tjlab-jf3hzb/All_mode_SDR/photo01.jpg

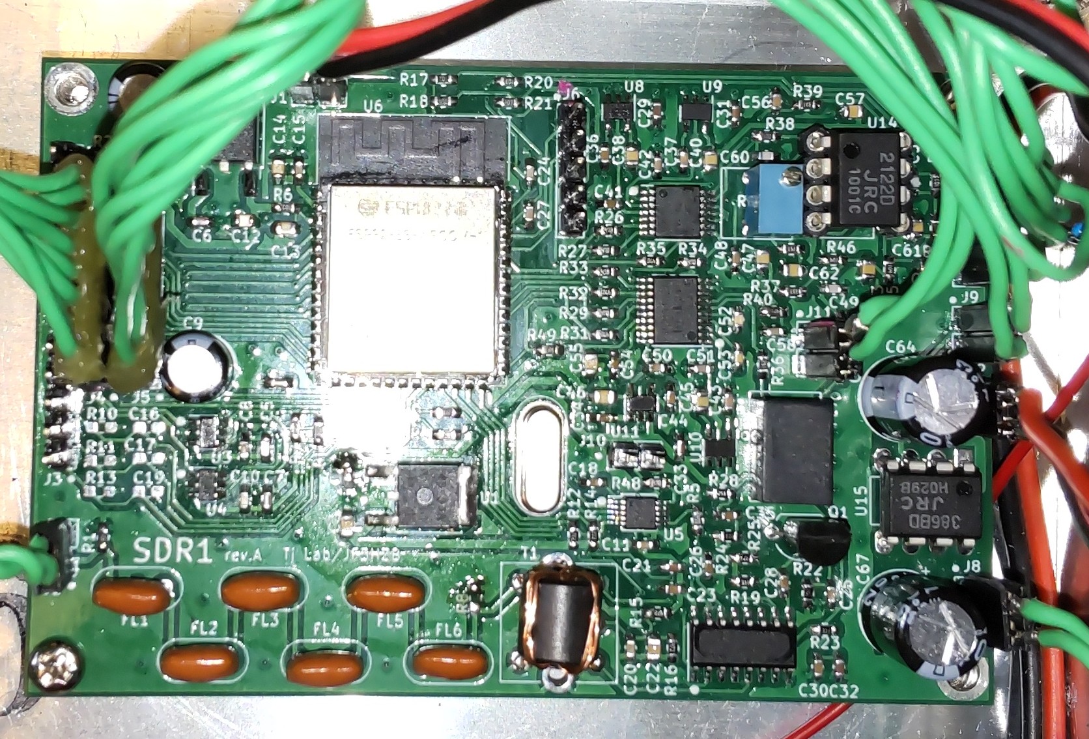
photo01.jpg
