tjlab-jf3hzb/All_mode_SDR/photo02.jpg

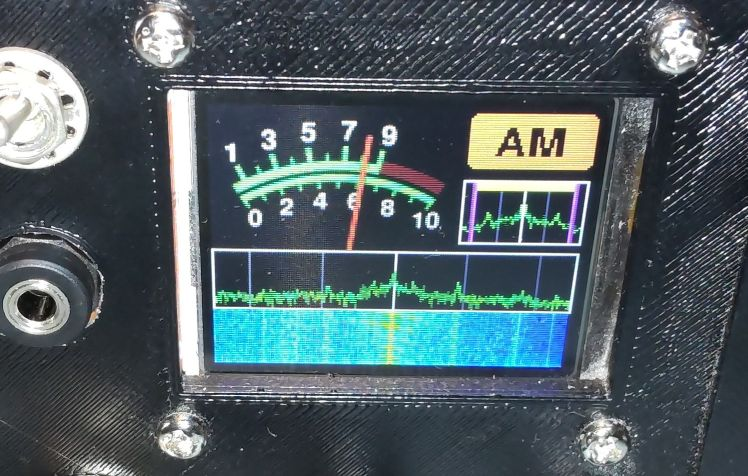
photo02.jpg
