tjlab-jf3hzb/All_mode_SDR/block_diagram.jpg

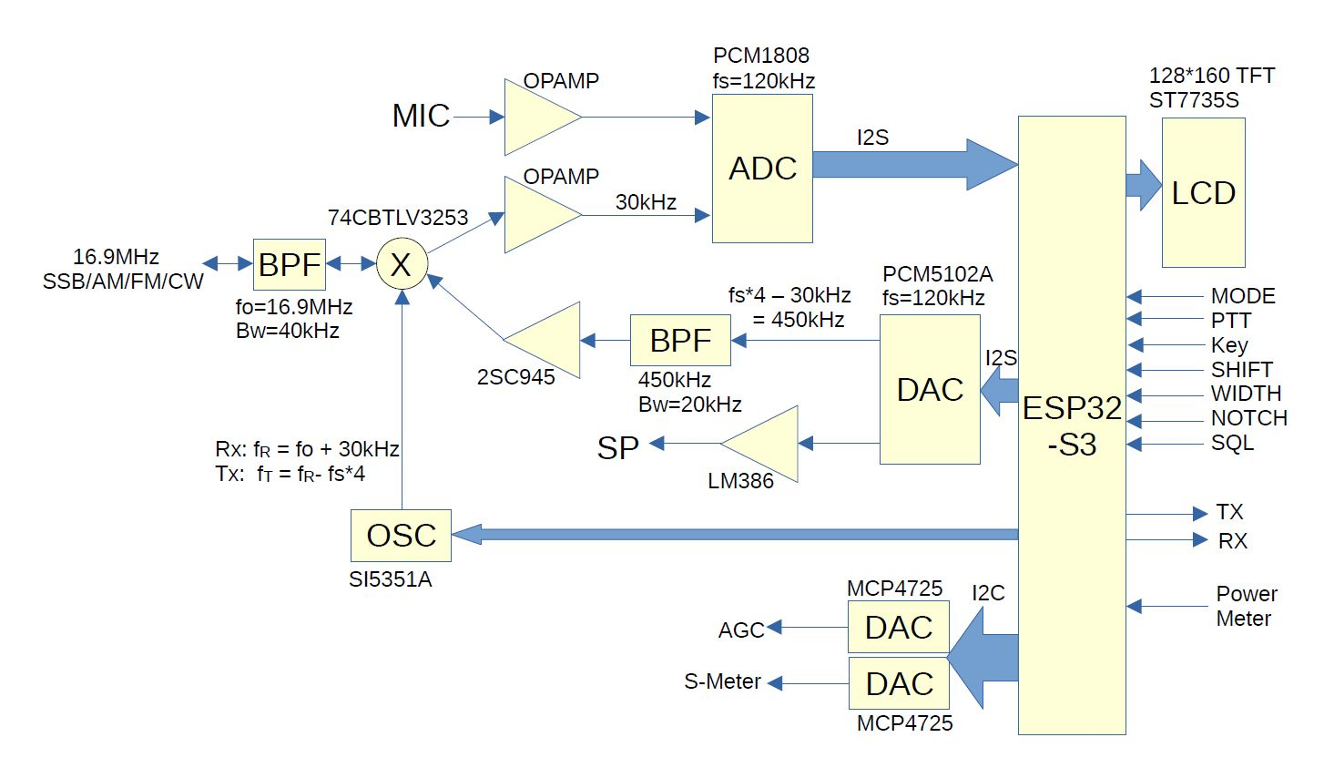
block_diagram.jpg
