tjlab-jf3hzb/All_mode_SDR/Compile_settings.jpg

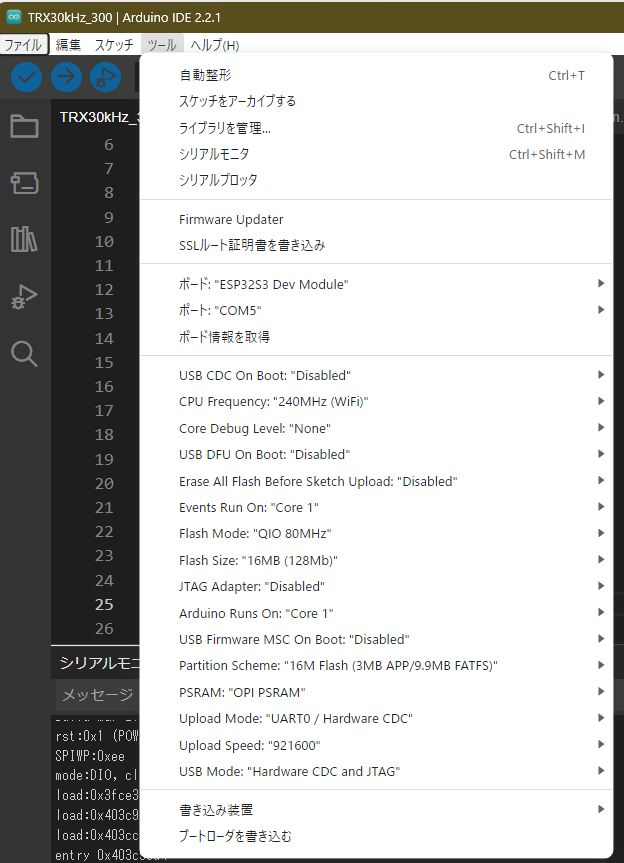
Compile_settings.jpg
