tjlab-jf3hzb/All_mode_SDR/connection_ver200.bmp

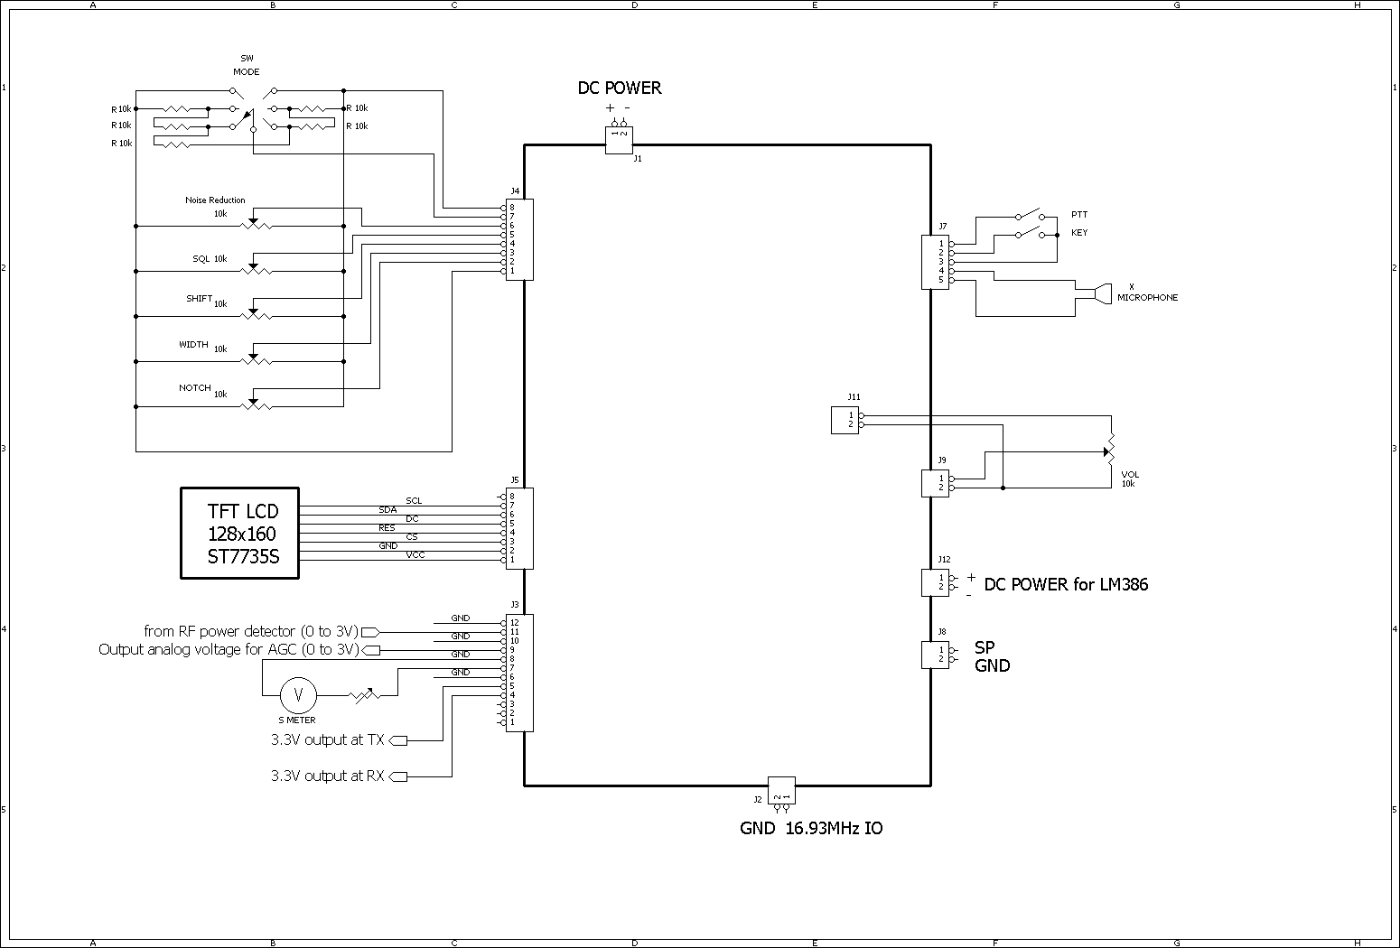
connection_ver200.bmp
