tjlab-jf3hzb/All_mode_SDR/schematic diagram.pdf

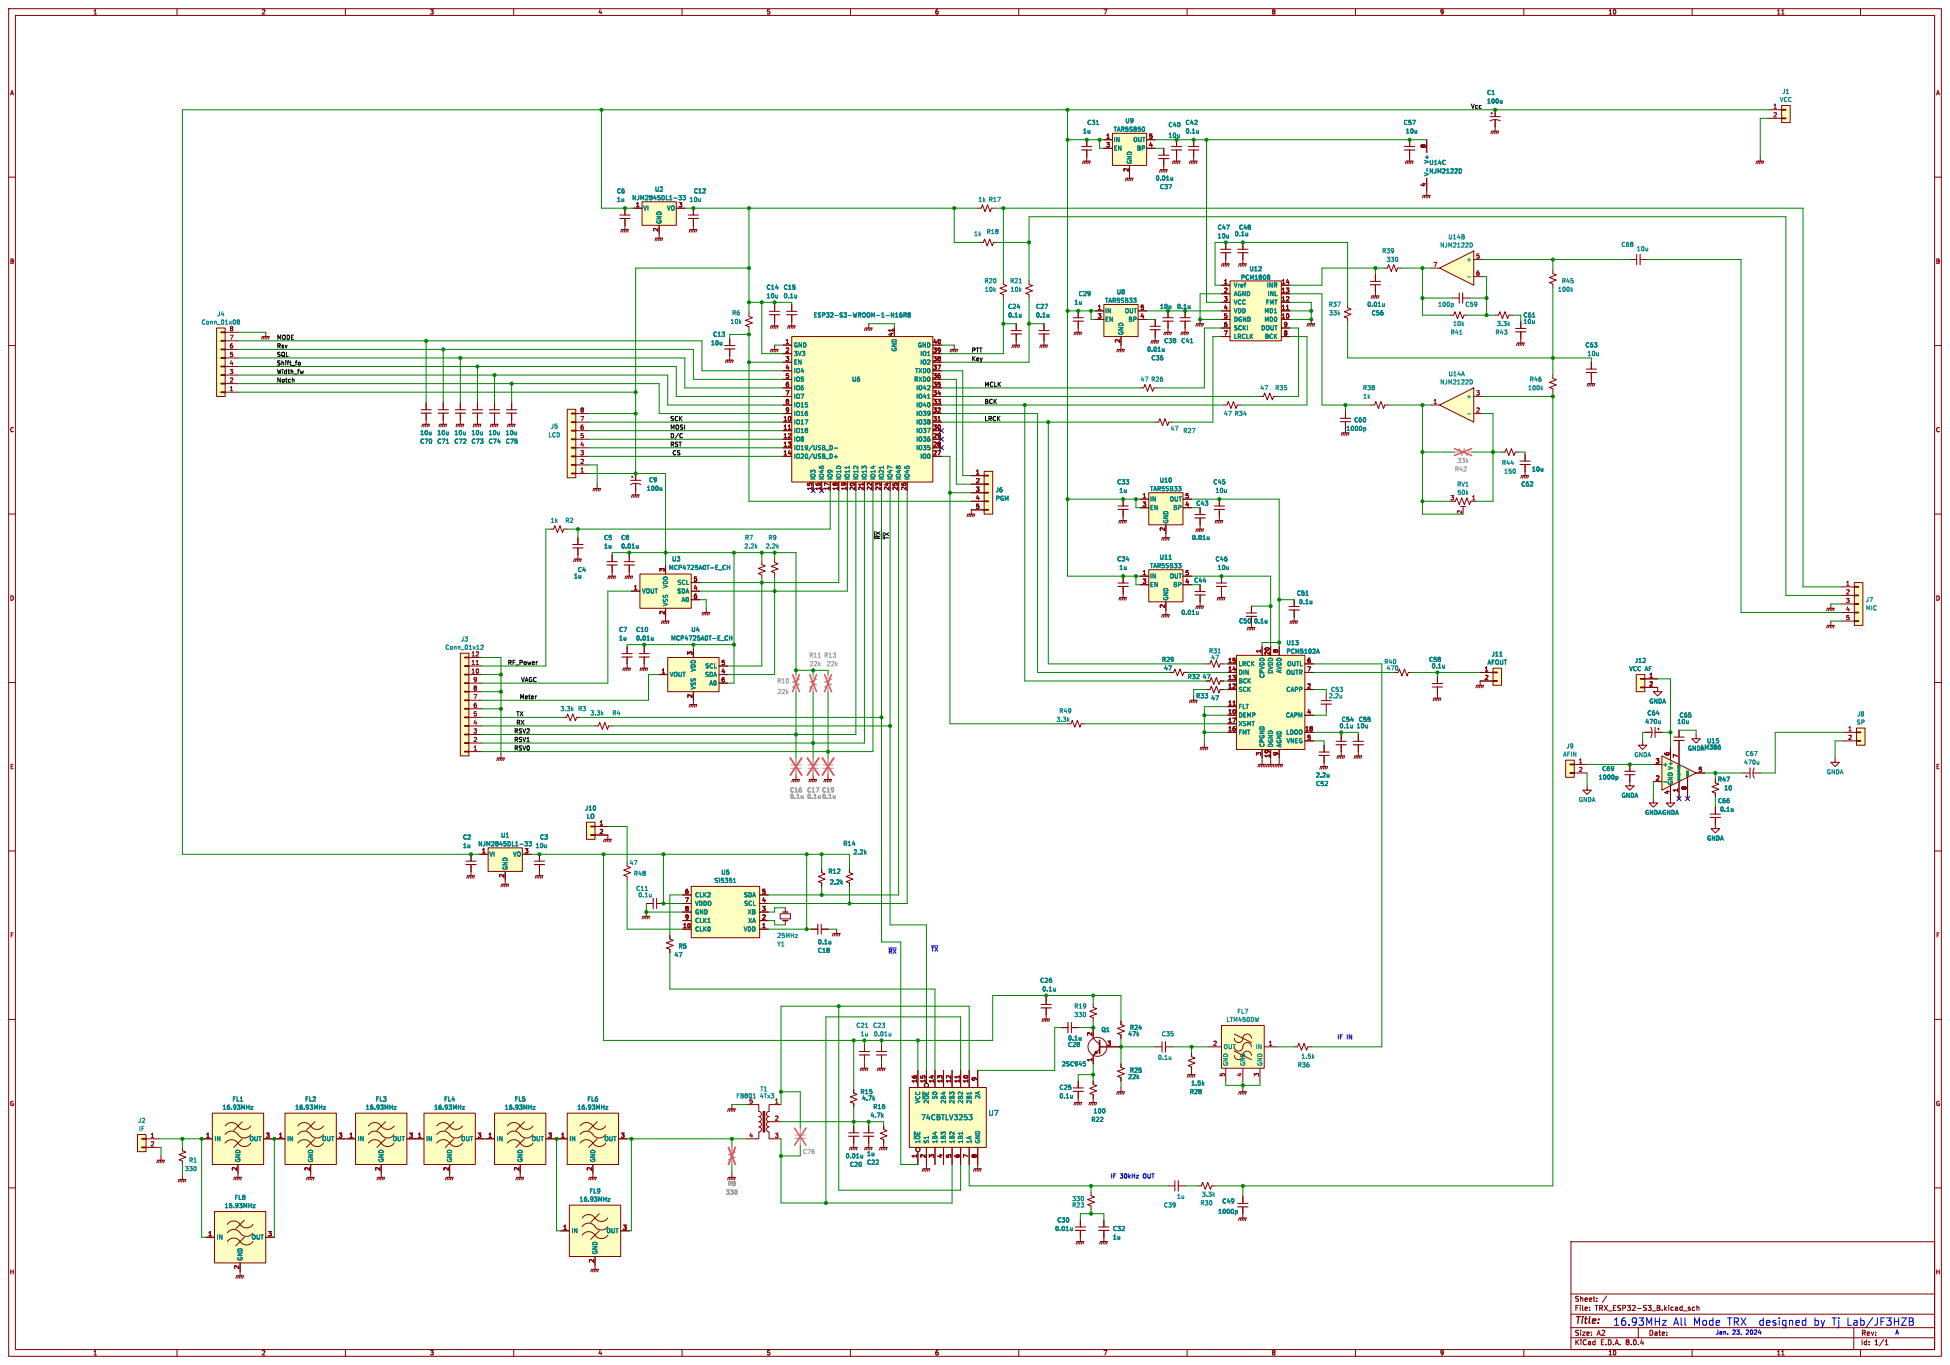
[picture p6: page 1]

2 OUT 3 U7 74CBTLV3253 1~{OE} 1 2B1 10 2B2 11 2B3 12 2B4 13 S0 14 2~{OE} 15 VCC 16 S1

A 16.93MHz All Mode TRX designed by Tj Lab/JF3HZB
