tjlab-jf3hzb/All_mode_SDR/trx16M_205/ejwt.h

#define Nb_max 12
#define Nmax  (1<<Nb_max)

// twiddle factor (real part)
const float wr[]={
1.000000000e+000,
9.999988235e-001,
9.999952938e-001,
9.999894111e-001,
9.999811753e-001,
9.999705864e-001,
9.999576446e-001,
9.999423497e-001,
9.999247018e-001,
9.999047011e-001,
9.998823475e-001,
9.998576410e-001,
9.998305818e-001,
9.998011699e-001,
9.997694054e-001,
9.997352883e-001,
9.996988187e-001,
9.996599967e-001,
9.996188225e-001,
9.995752960e-001,
9.995294175e-001,
9.994811870e-001,
9.994306046e-001,
9.993776704e-001,
9.993223846e-001,
9.992647473e-001,
9.992047586e-001,
9.991424187e-001,
9.990777278e-001,
9.990106859e-001,
9.989412932e-001,
9.988695499e-001,
9.987954562e-001,
9.987190122e-001,
9.986402182e-001,
9.985590742e-001,
9.984755806e-001,
9.983897374e-001,
9.983015449e-001,
9.982110034e-001,
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
};

// twiddle factor (imaginary part)
const float wi[]={
-0.000000000e+000,
-1.533980186e-003,
-3.067956763e-003,
-4.601926120e-003,
-6.135884649e-003,
-7.669828740e-003,
-9.203754782e-003,
-1.073765917e-002,
-1.227153829e-002,
-1.380538853e-002,
-1.533920628e-002,
-1.687298795e-002,
-1.840672991e-002,
-1.994042855e-002,
-2.147408028e-002,
-2.300768147e-002,
-2.454122852e-002,
-2.607471783e-002,
-2.760814578e-002,
-2.914150876e-002,
-3.067480318e-002,
-3.220802541e-002,
-3.374117185e-002,
-3.527423890e-002,
-3.680722294e-002,
-3.834012037e-002,
-3.987292759e-002,
-4.140564098e-002,
-4.293825693e-002,
-4.447077185e-002,
-4.600318213e-002,
-4.753548416e-002,
-4.906767433e-002,
-5.059974904e-002,
-5.213170468e-002,
-5.366353765e-002,
-5.519524435e-002,
-5.672682117e-002,
-5.825826450e-002,
-5.978957075e-002,
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
};
