tjlab-jf3hzb/All_mode_SDR/trx16M_205/ST7735S_128x160_2.hpp

#ifndef DISPLAY_H
#define	DISPLAY_H

#include <LovyanGFX.hpp>
class LGFX : public lgfx::LGFX_Device
{
  lgfx::Panel_ST7735S _panel_instance;
  lgfx::Bus_SPI       _bus_instance;

public:
  LGFX(void)
  {
    { // // SPIバスの設定
      auto cfg = _bus_instance.config();    // バス設定用の構造体を取得します。
      cfg.spi_host = SPI3_HOST;     // 使用するSPIを選択  ESP32-S2,C3 : SPI2_HOST or SPI3_HOST / ESP32 : VSPI_HOST or HSPI_HOST
      // ※ ESP-IDFバージョンアップに伴い、VSPI_HOST , HSPI_HOSTの記述は非推奨になるため、エラーが出る場合は代わりにSPI2_HOST , SPI3_HOSTを使用してください。
      cfg.spi_mode = 0;             // SPI通信モードを設定 (0 ~ 3)
      cfg.freq_write = 27000000;    // 送信時のSPIクロック (最大80MHz, 80MHzを整数で割った値に丸められます)
      cfg.freq_read  = 16000000;    // 受信時のSPIクロック
      cfg.spi_3wire  = false;        // 受信をMOSIピンで行う場合はtrueを設定
      cfg.use_lock   = true;        // トランザクションロックを使用する場合はtrueを設定
      cfg.dma_channel = SPI_DMA_CH_AUTO; // 使用するDMAチャンネルを設定 (0=DMA不使用 / 1=1ch / 2=ch / SPI_DMA_CH_AUTO=自動設定)
      // ※ ESP-IDFバージョンアップに伴い、DMAチャンネルはSPI_DMA_CH_AUTO(自動設定)が推奨になりました。1ch,2chの指定は非推奨になります。
      cfg.pin_sclk = 17;            // SPIのSCLKピン番号を設定
      cfg.pin_mosi = 18;            // SPIのMOSIピン番号を設定
      cfg.pin_miso = -1;            // SPIのMISOピン番号を設定 (-1 = disable)
      cfg.pin_dc   =  8;            // SPIのD/Cピン番号を設定  (-1 = disable)
      _bus_instance.config(cfg);    // 設定値をバスに反映します。
      _panel_instance.setBus(&_bus_instance);      // バスをパネルにセットします。
    }

    { // 表示パネル制御の設定を行います。
      auto cfg = _panel_instance.config();    // 表示パネル設定用の構造体を取得します。
      cfg.pin_cs           =   20;  // CSが接続されているピン番号   (-1 = disable)
      cfg.pin_rst          =   19;  // RSTが接続されているピン番号  (-1 = disable)
      cfg.pin_busy         =   -1;  // BUSYが接続されているピン番号 (-1 = disable)

      // ※ 以下の設定値はパネル毎に一般的な初期値が設定されていますので、不明な項目はコメントアウトして試してみてください。

      cfg.panel_width      =   128;  // 実際に表示可能な幅
      cfg.panel_height     =   160;  // 実際に表示可能な高さ
      cfg.offset_x         =     2;  // パネルのX方向オフセット量
      cfg.offset_y         =    -1;  // パネルのY方向オフセット量
      cfg.offset_rotation  =     3;  // 回転方向の値のオフセット 0~7 (4~7は上下反転)
      cfg.dummy_read_pixel =     8;  // ピクセル読出し前のダミーリードのビット数
      cfg.dummy_read_bits  =     1;  // ピクセル以外のデータ読出し前のダミーリードのビット数
      cfg.readable         = false;  // データ読出しが可能な場合 trueに設定
      cfg.invert           = false;  // パネルの明暗が反転してしまう場合 trueに設定
      cfg.rgb_order        =  true;  // パネルの赤と青が入れ替わってしまう場合 trueに設定
      cfg.dlen_16bit       = false;  // 16bitパラレルやSPIでデータ長を16bit単位で送信するパネルの場合 trueに設定, false: 8bit
      cfg.bus_shared       = false;  // SDカードとバスを共有している場合 trueに設定(drawJpgFile等でバス制御を行います)

      // 以下はST7735やILI9163のようにピクセル数が可変のドライバで表示がずれる場合にのみ設定してください。
      cfg.memory_width     =   128;  // ドライバICがサポートしている最大の幅
      cfg.memory_height    =   160;  // ドライバICがサポートしている最大の高さ

      _panel_instance.config(cfg);
    }   
    setPanel(&_panel_instance); // 使用するパネルをセットします。
  }
};

#endif
