tjlab-jf3hzb/All_mode_SDR/trx16M_205/fft.h

/*
    File:   fft.hpp
    Author: JF3HZB / T. Uebo
 
    Created on June 10, 2025
*/
#ifndef _fft_
#define _fft_

void fft(float *a, int Len);
void ifft(float *a, int Len);
float invsqrt(float a);

#endif
