tjlab-jf3hzb/All_mode_SDR/trx16M_205/si5351.h

/* 
 * File:   si5351.h
 * Author: JF3HZB / T. Uebo
 *
 * Created on 2019/02/11, 23:07
 */


#ifndef __si5351H___
#define __si5351H___

#include "prm.h"

void si5351_init(void);
void set_freq(unsigned long freq);
void set_car_freq(unsigned long freq, unsigned char EN, unsigned char RST);
void cmd_si5351_block(unsigned char reg_No, unsigned char *d);

#endif
