tjlab-jf3hzb/All_mode_SDR/(commit log)

2024-02-07 updated code and doc.
    [BOM.csv]
2024-03-04 ver. 1.01
    MAX band width at CW 500Hz -> 1kHz
2024-07-09 CW filter changed to Gaussian filter
2024-09-29 Create schematic diagram_revB.pdf
2025-04-15 ver. 1.07
    bug fix
    [ST7735S_128x160.hpp, ST7735S_128x160_2.hpp]
2025-06-11 Ver. 2.00. Add noise reduction and AM squelch.
    Noise reduction is achieved using Spectral Subtraction
    [ST7735S_128x160.hpp, ST7735S_128x160_2.hpp]
2025-06-14 Ver. 2.02. Reduce popping noise.
    [ST7735S_128x160.hpp, ST7735S_128x160_2.hpp]
2026-01-08 S-meter frame added
